kirby6365/voltra_ring_nano/case/stl/voltra_ring_nano_lid.stl

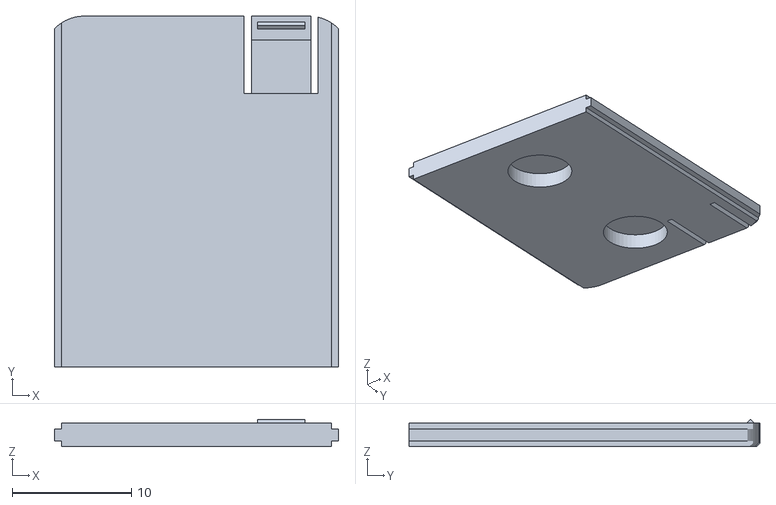
[picture p6: CAD file, 2026-11-13]
case/stl/voltra_ring_nano_lid.stl
23.8 x 29.4 x 2.30
