kirby6365/voltra_ring_nano/case/stl/voltra_ring_nano_tub.stl

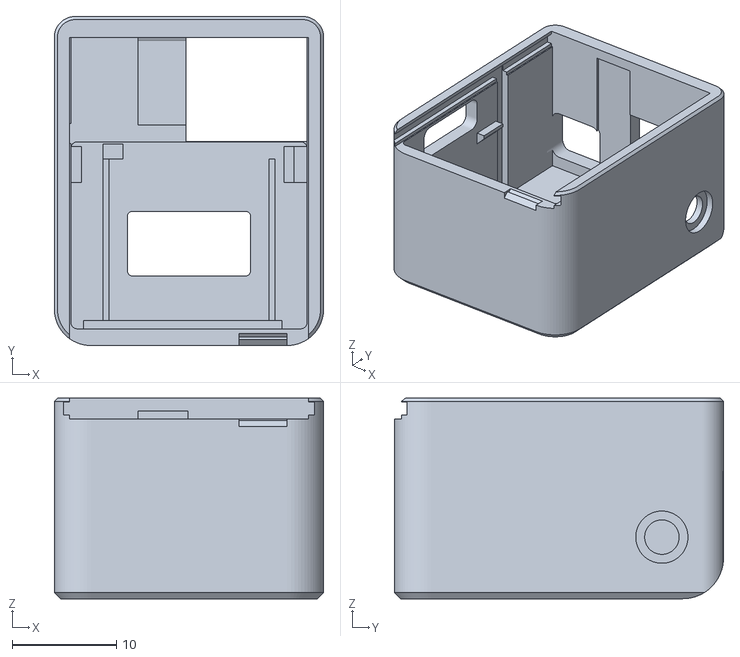
[picture p7: CAD file, 2026-11-13]
case/stl/voltra_ring_nano_tub.stl
25.8 x 31.5 x 19.2
