kirby6365/voltra_ring_nano/case/stl/voltra_ring_nano_liner_b.stl

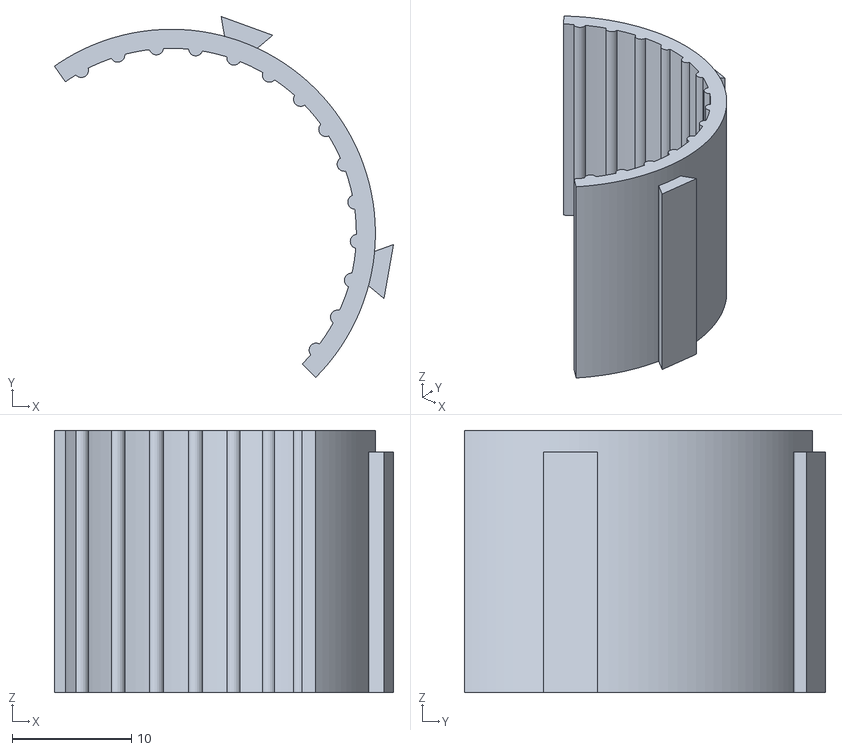
[picture p8: CAD file, 2026-11-13]
case/stl/voltra_ring_nano_liner_b.stl
28.4 x 30.3 x 22.0
