kirby6365/voltra_ring_nano/case/stl/voltra_ring_nano_fit_tips.stl

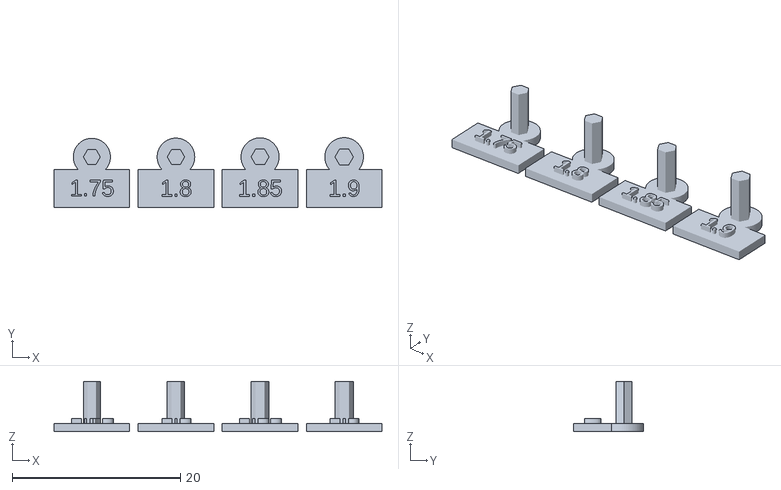
[picture p9: CAD file, 2026-11-13]
case/stl/voltra_ring_nano_fit_tips.stl
39.0 x 8.30 x 6.00
