kirby6365/voltra_ring_nano/case/stl/voltra_ring_nano_fit_test.stl

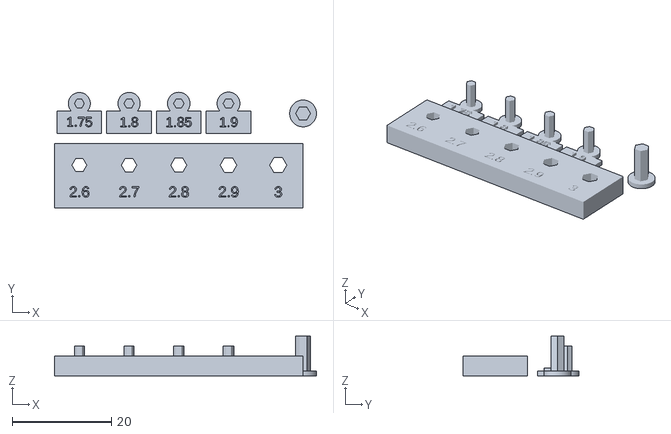
[picture p10: CAD file, 2026-11-13]
case/stl/voltra_ring_nano_fit_test.stl
52.7 x 23.3 x 8.00
