kirby6365/voltra_ring_nano/case/stl/voltra_ring_nano_band_13.stl

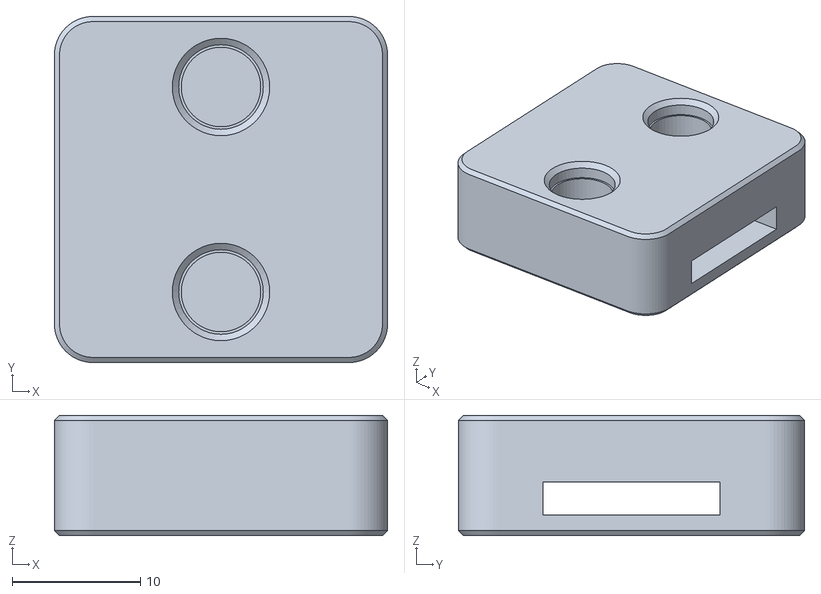
[picture p11: CAD file, 2026-11-13]
case/stl/voltra_ring_nano_band_13.stl
26.0 x 27.0 x 9.40
