kirby6365/voltra_ring_nano/case/stl/voltra_ring_nano_clip_a.stl

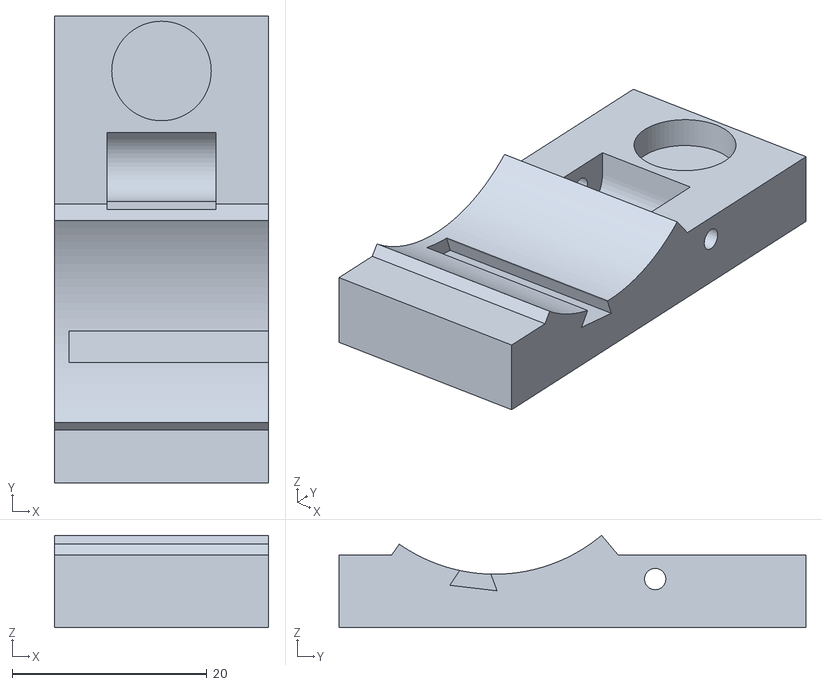
[picture p12: CAD file, 2026-11-13]
case/stl/voltra_ring_nano_clip_a.stl
22.0 x 48.0 x 9.50
