kirby6365/voltra_ring_nano/case/stl/voltra_ring_nano_liner_a.stl

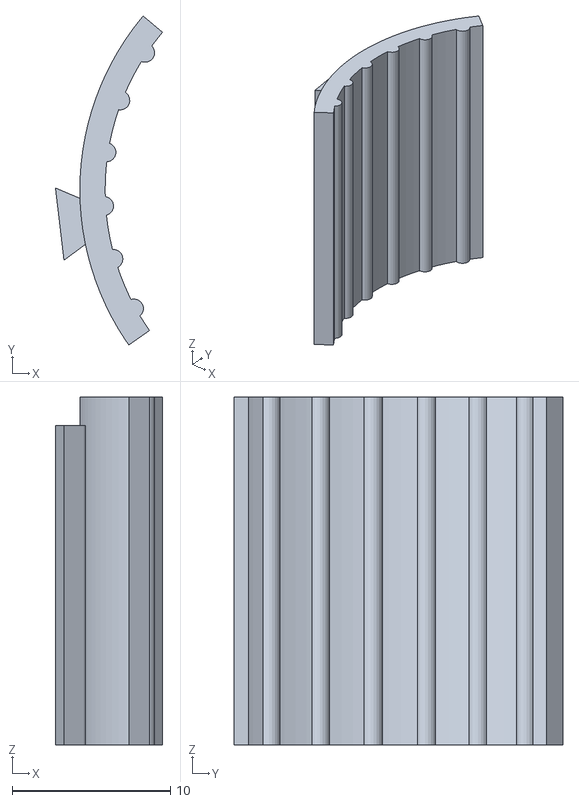
[picture p13: CAD file, 2026-11-13]
case/stl/voltra_ring_nano_liner_a.stl
6.77 x 20.8 x 22.0
