kirby6365/voltra_ring_nano/case/stl/voltra_ring_nano_shaft.stl

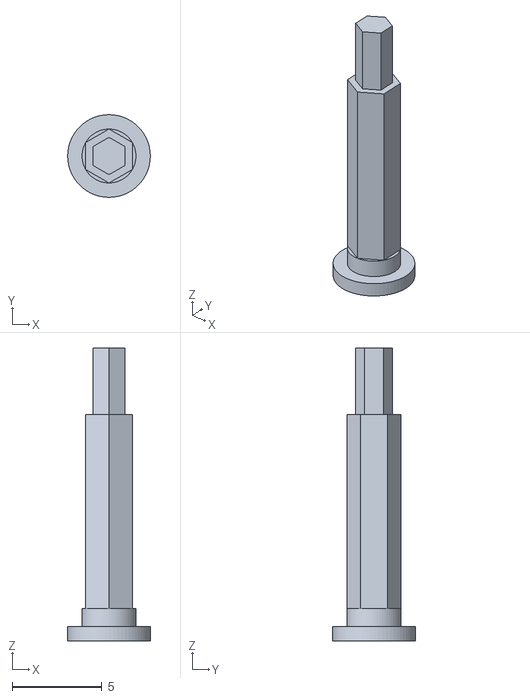
[picture p14: CAD file, 2026-11-13]
case/stl/voltra_ring_nano_shaft.stl
4.60 x 4.60 x 16.3
