kirby6365/voltra_ring_nano/case/stl/voltra_ring_nano_clip_b.stl

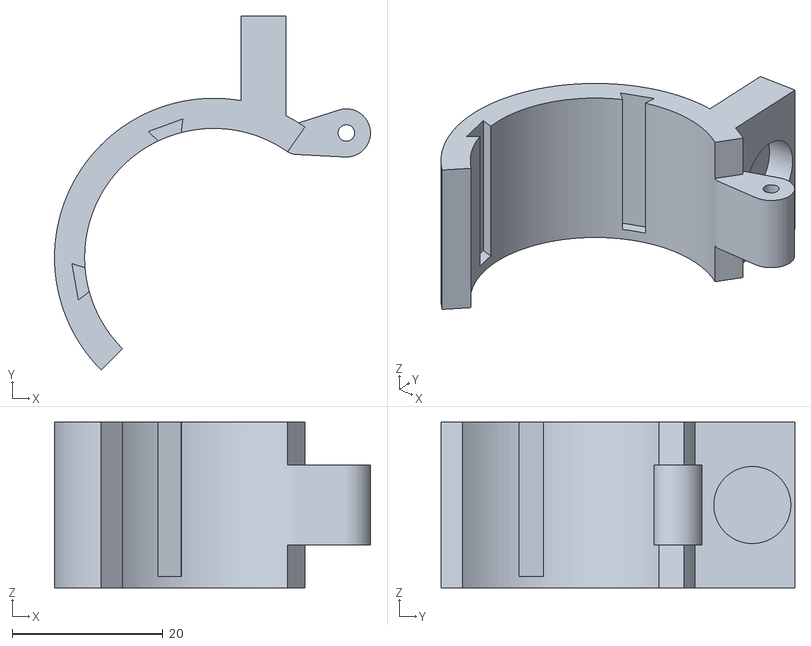
[picture p15: CAD file, 2026-11-13]
case/stl/voltra_ring_nano_clip_b.stl
41.9 x 46.9 x 22.0
