kirby6365/voltra_ring_nano/case/stl/voltra_ring_nano_band_20.stl

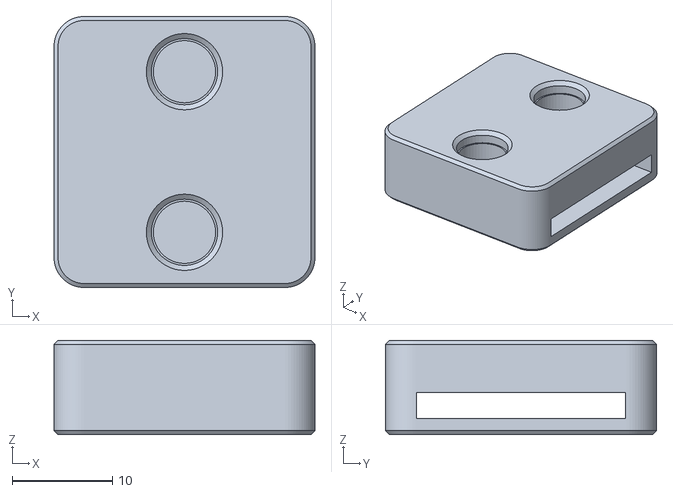
[picture p16: CAD file, 2026-11-13]
case/stl/voltra_ring_nano_band_20.stl
26.0 x 27.0 x 9.40
