kirby6365/voltra_ring_nano/case/stl/voltra_ring_nano_button.stl

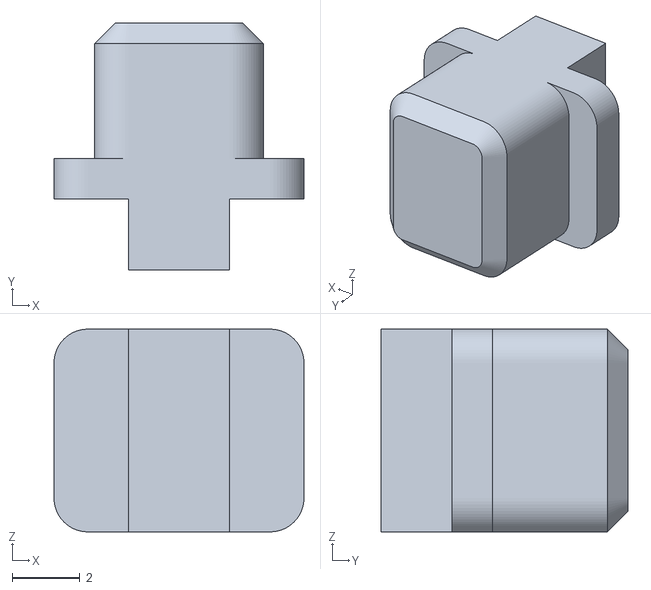
[picture p17: CAD file, 2026-11-13]
case/stl/voltra_ring_nano_button.stl
7.40 x 7.30 x 6.00
