kirby6365/voltra_ring_nano/case/stl/voltra_ring_nano_wheel.stl

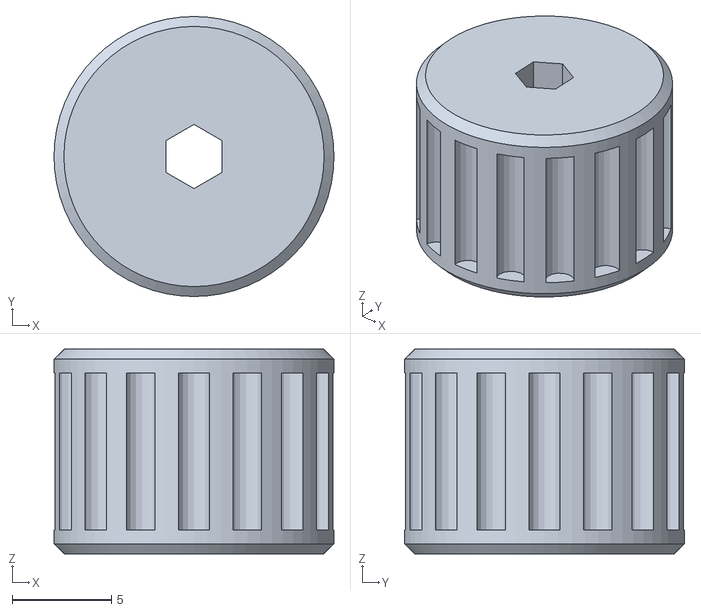
[picture p18: CAD file, 2026-11-13]
case/stl/voltra_ring_nano_wheel.stl
14.1 x 14.1 x 10.3
